jackalaka21/MnT_exoskeleton/Exoskeleton Poster.jpg

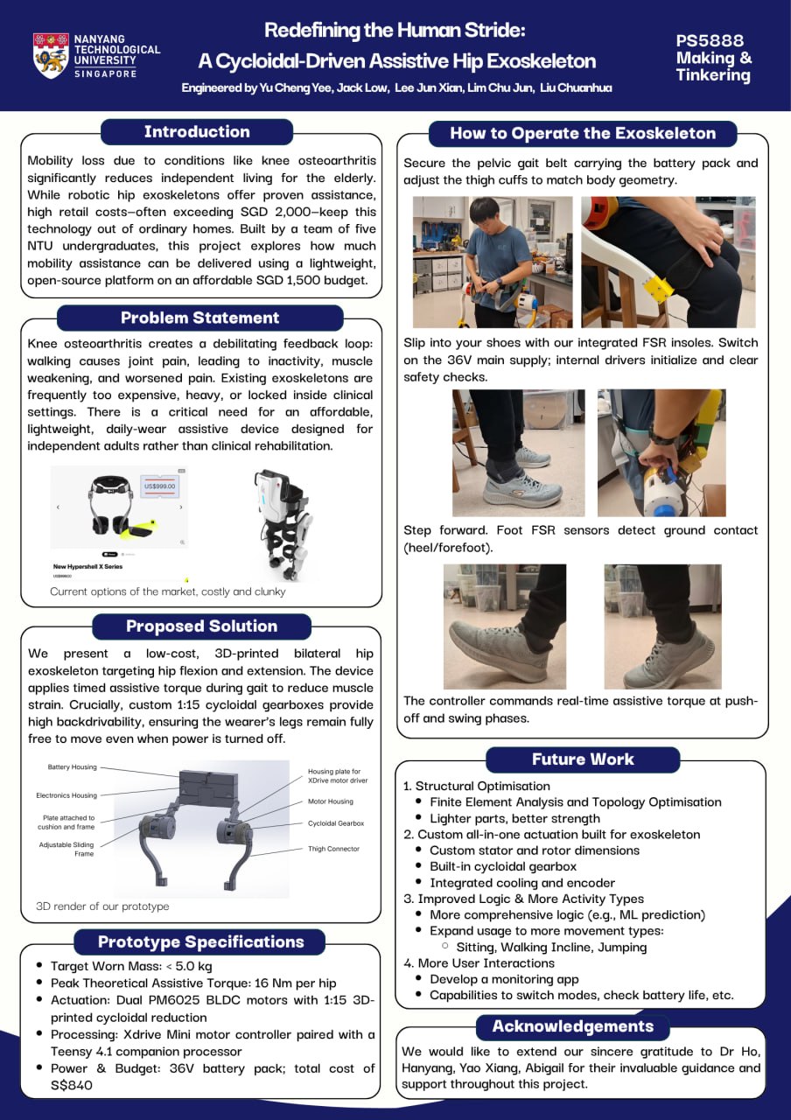
Exoskeleton Poster.jpg
