jackalaka21/MnT_exoskeleton/PS5888_Cycloidal_Driven_Exoskeleton.pdf

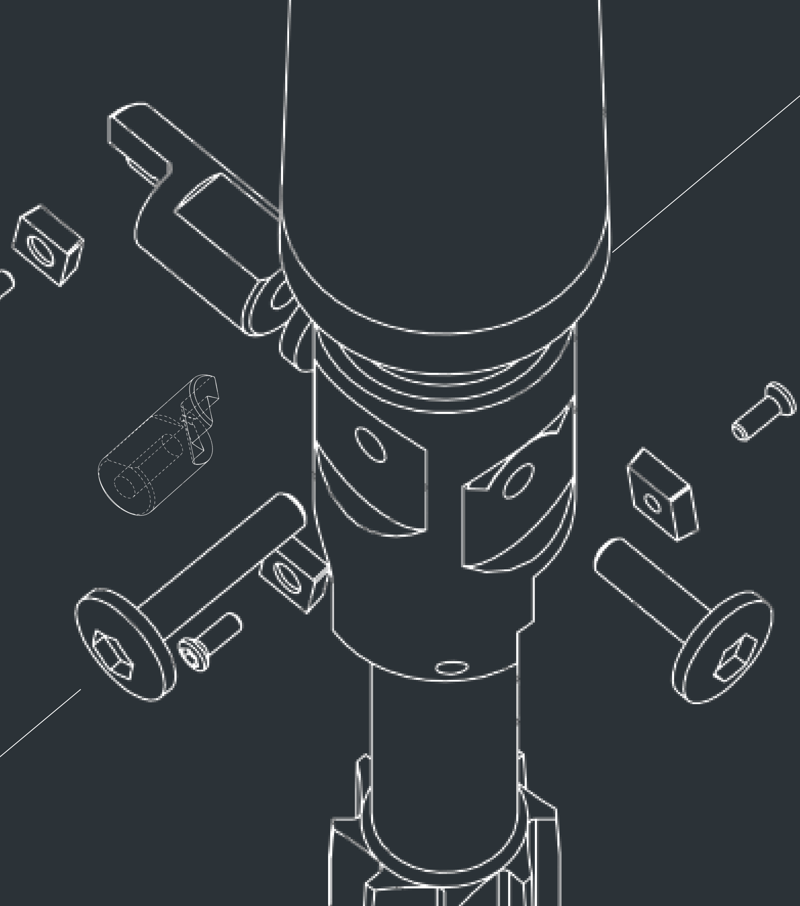
[picture p2: figure]

PRESENTED BY:
YU CHENG YEE, LIU CHUANHUA, LEE JUN XIAN, JACK LOW EE JIN, AND LIM CHU JUN

# Redefining the Human Stride

# Cycloidal-Driven Assistive Hip Exoskeleton

PS5888
Making and Tinkering

1

## The Freedom of Movement

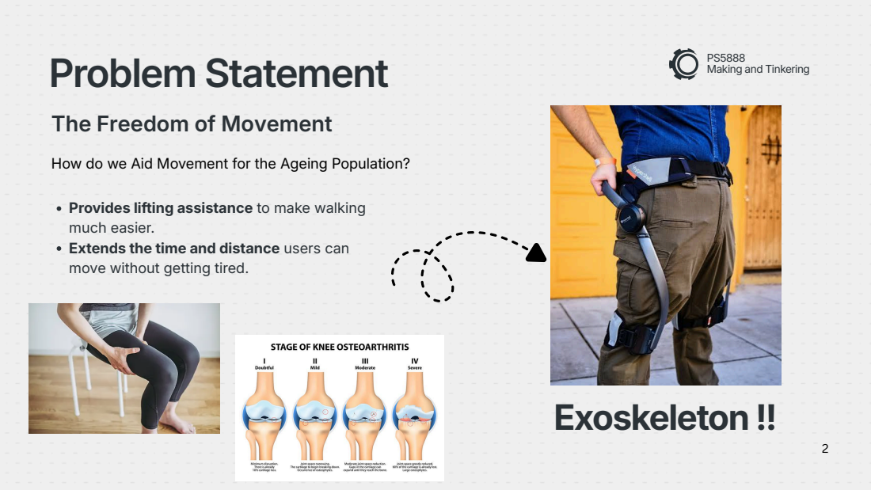
[picture p3: page 2]
Exoskeleton !!

Making and Tinkering Problem Statement

How do we Aid Movement for the Ageing Population?

Provides lifting assistance to make walking
much easier.
Extends the time and distance users can
move without getting tired.

# Problem Statement

However....

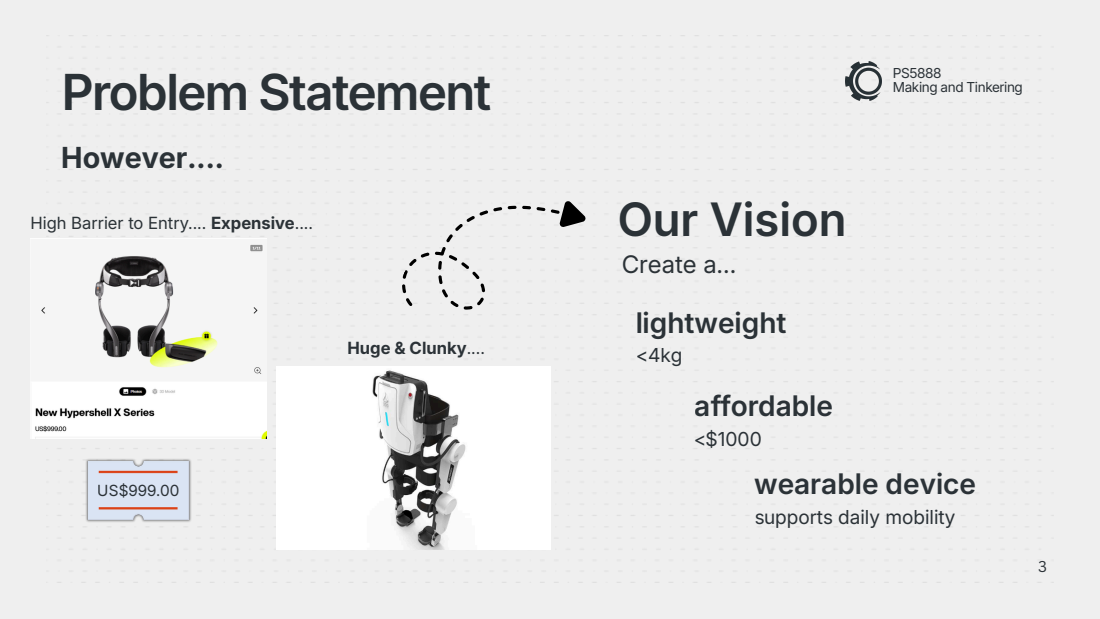
[picture p4: page 3]
lightweight; affordable; wearable device; supports daily mobility; High Barrier to Entry.... Expensive....; Our Vision; Create a...; Huge & Clunky....

Making and Tinkering

# Proposed Initial Design

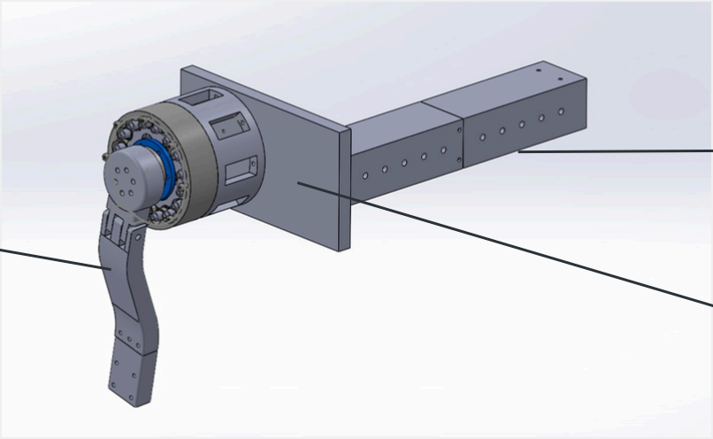
[picture p5: figure]

Flat housing
plate

Hip
Component

Railing + Box for
electronics
(undesigned)

# Initial Circuit Schematics

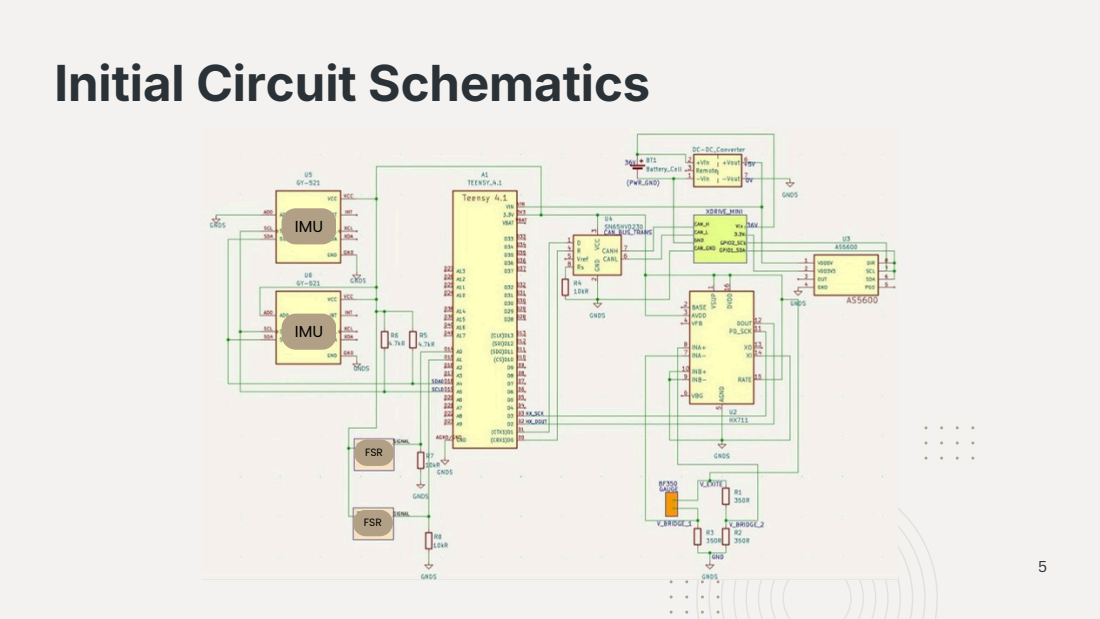
[picture p6: page 5]
IMU; FSR

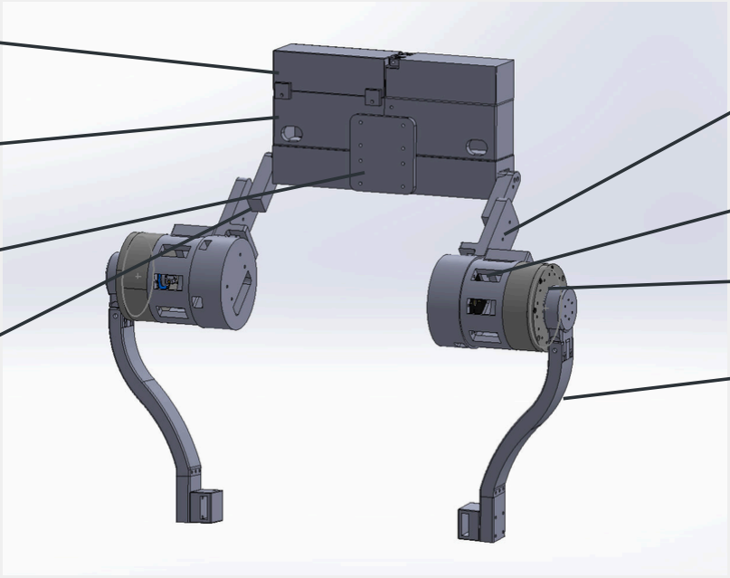
[picture p7: figure]

Battery housing

# Proposed Final Design

Cycloidal gearbox

Motor housing

Housing plate for
Odrive Motor Driver

Electronics housing

Adjustable Sliding
Frame

Plate attached to
cushion and frame

Thigh connector

# Final Circuit Design/Circuitry

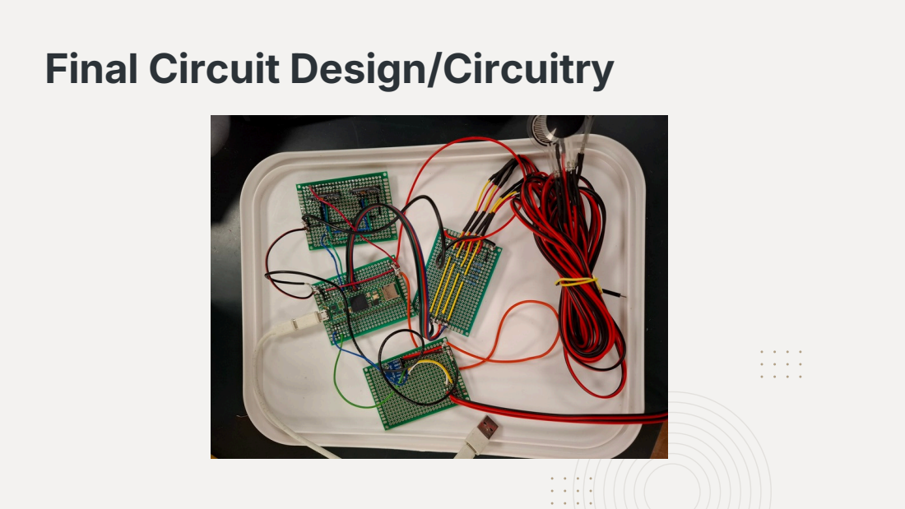
[picture p8: page 7]

# Final Product

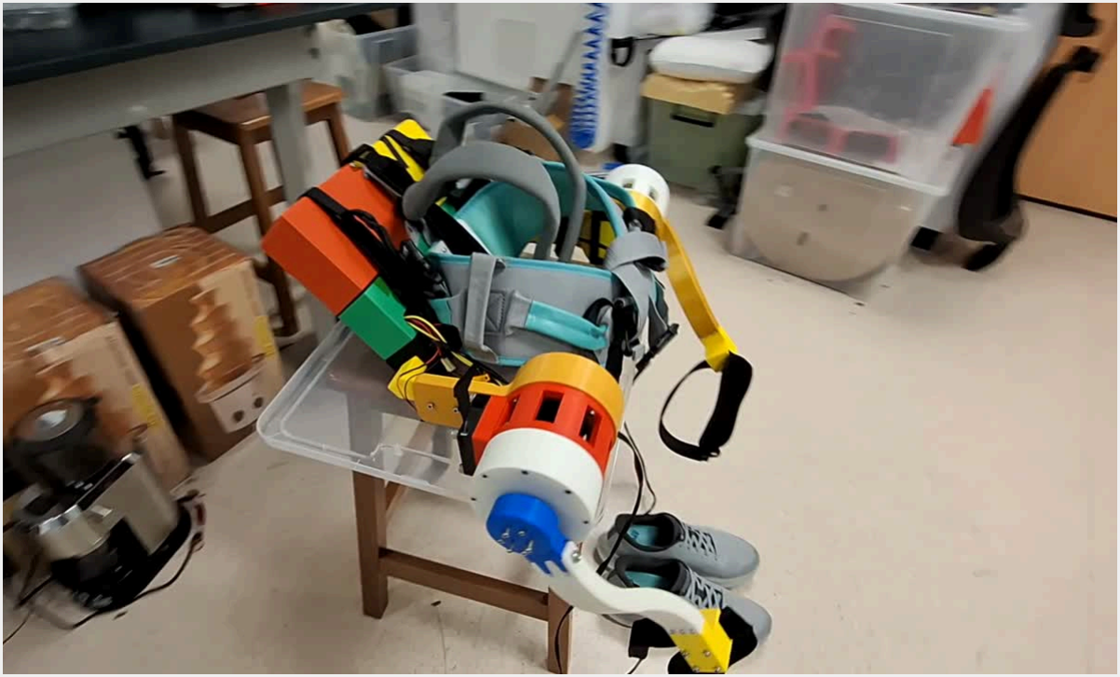
[picture p9: figure]

# Overcame Challenges

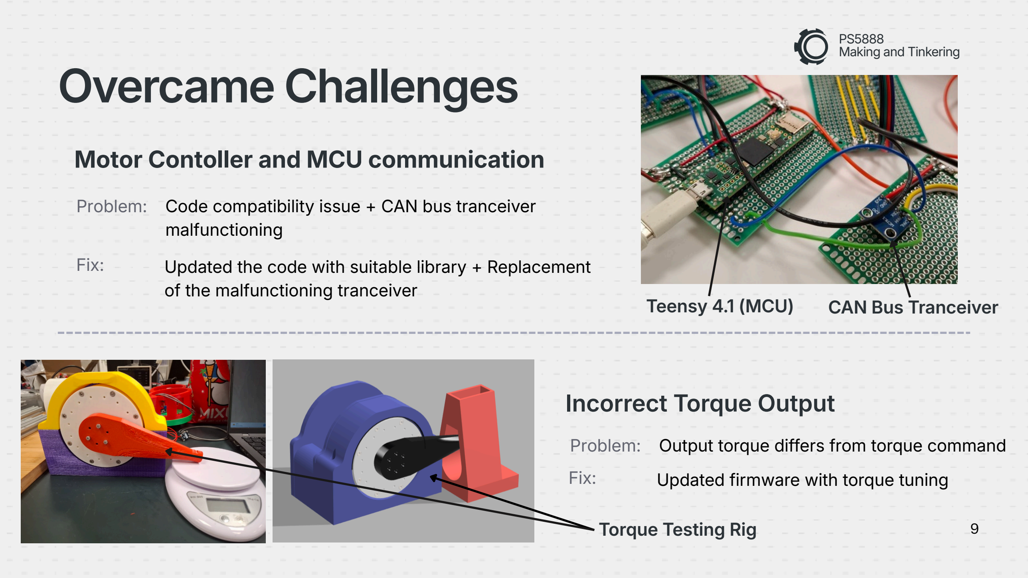
[picture p10: page 9]

PS5888
Making and Tinkering

Torque Testing Rig

Code compatibility issue + CAN bus tranceiver malfunctioning

Updated the code with suitable library + Replacement of the malfunctioning tranceiver

## Motor Contoller and MCU communication

## Incorrect Torque Output

Problem:

Fix:

Output torque differs from torque command Updated firmware with torque tuning

Problem:
Fix:

Teensy 4.1 (MCU) CAN Bus Tranceiver

9

# Overcame Challenges

## Structural Failure Under Stress

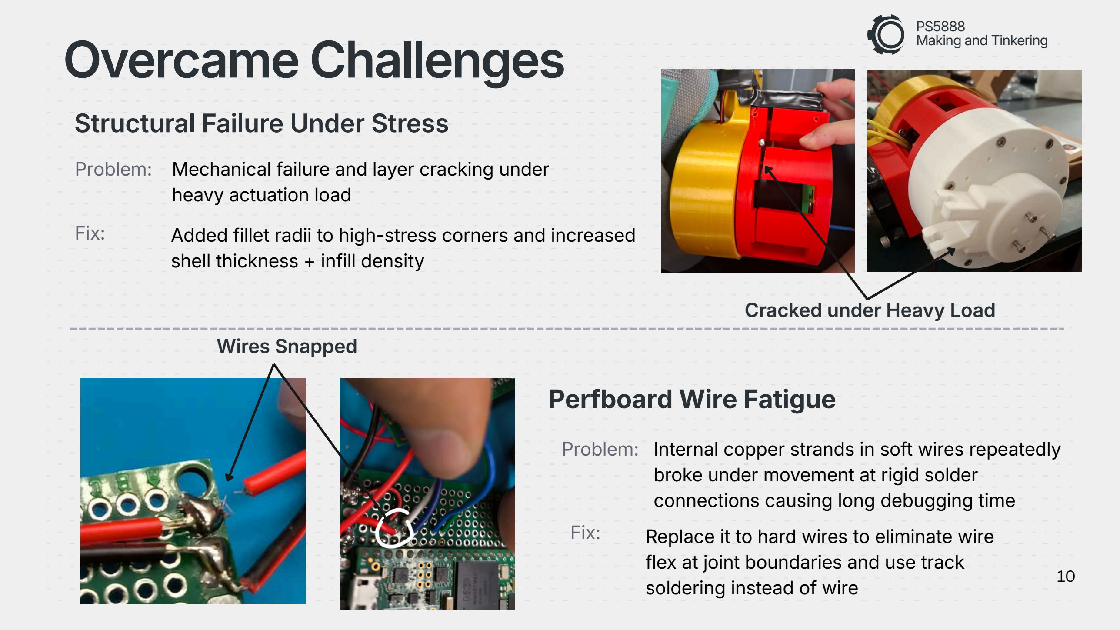
[picture p11: page 10]

PS5888
Making and Tinkering

Cracked under Heavy Load

## Perfboard Wire Fatigue

Internal copper strands in soft wires repeatedly broke under movement at rigid solder connections causing long debugging time Replace it to hard wires to eliminate wire
flex at joint boundaries and use track soldering instead of wire

Problem:

Fix:

Mechanical failure and layer cracking under
heavy actuation load

Added fillet radii to high-stress corners and increased shell thickness + infill density

Problem:

Fix:

Wires Snapped

10

# Challenges to Overcome

## Weight and Size

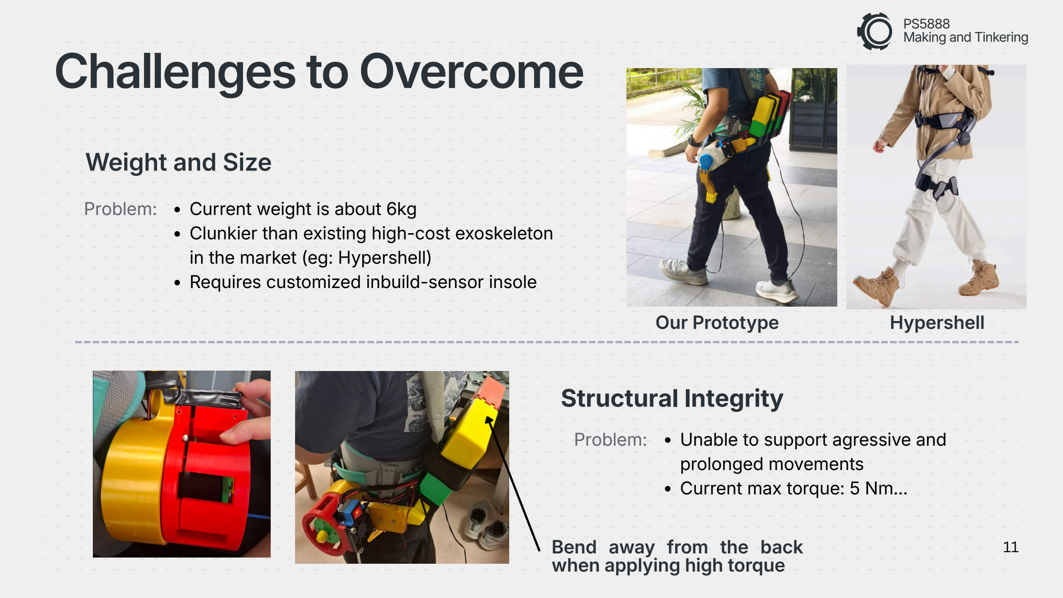
[picture p12: page 11]

PS5888
Making and Tinkering

## Structural Integrity

Unable to support agressive and prolonged movements
Current max torque: 5 Nm...

Problem:

Current weight is about 6kg
Clunkier than existing high-cost exoskeleton in the market (eg: Hypershell)
Requires customized inbuild-sensor insole

Problem:

Our Prototype | Hypershell

Bend away from the back
when applying high torque

11

# Challenges to Overcome

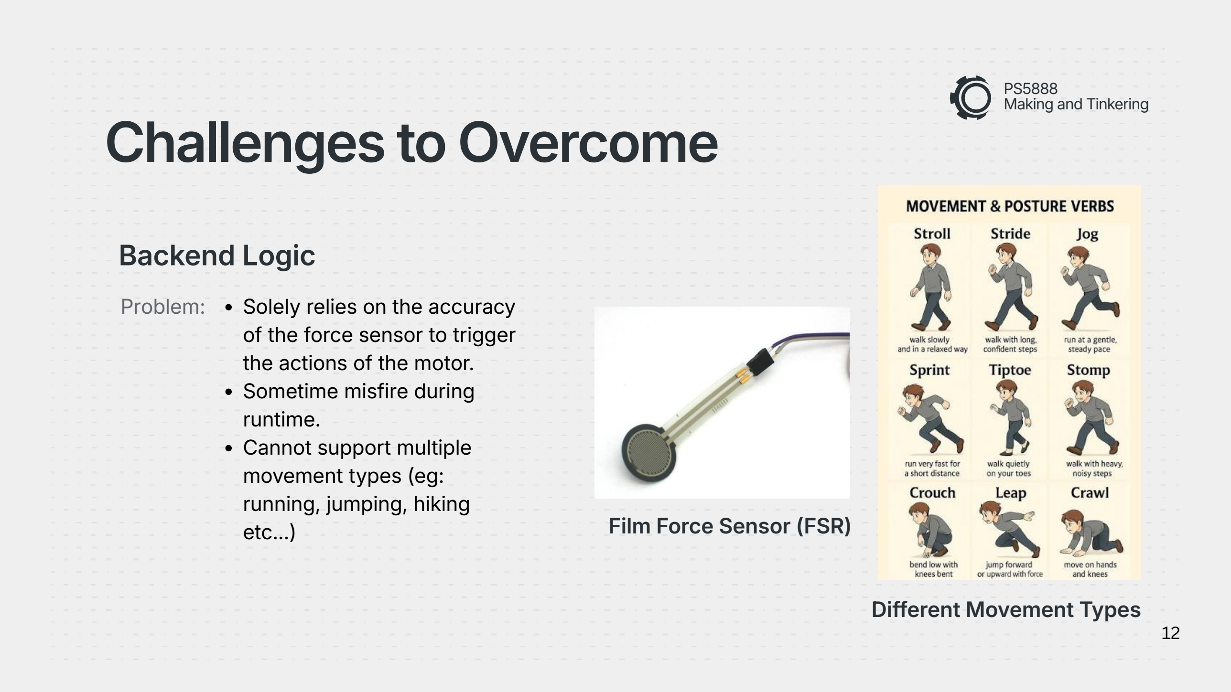
[picture p13: page 12]

PS5888
Making and Tinkering

## Backend Logic

Solely relies on the accuracy of the force sensor to trigger the actions of the motor.
Sometime misfire during
runtime.
Cannot support multiple
movement types (eg:
running, jumping, hiking
etc...)

Problem:

12

Film Force Sensor (FSR)

Different Movement Types

# Role of AI

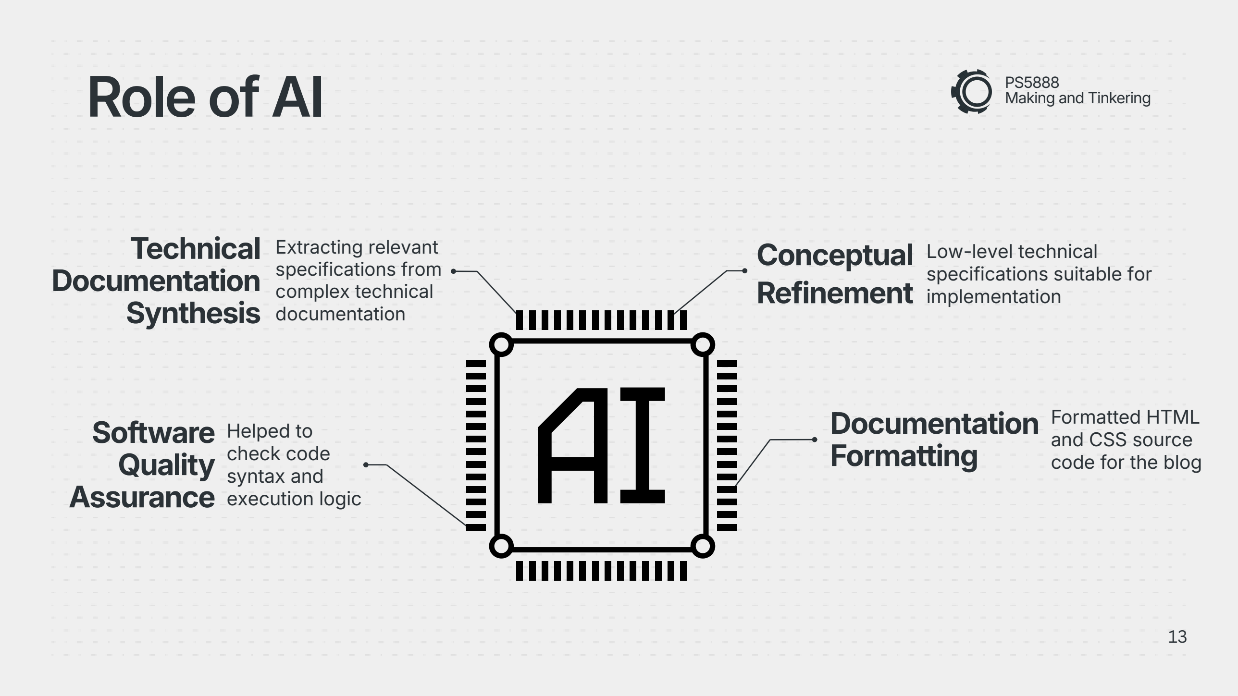
[picture p14: page 13]

## Technical Documentation Synthesis

## Conceptual Refinement

## Documentation Formatting

## Software Quality Assurance

Helped to
check code
syntax and
execution logic

Formatted HTML
and CSS source
code for the blog

Extracting relevant
specifications from
complex technical
documentation

Low-level technical
specifications suitable for implementation

PS5888
Making and Tinkering

13

# Structural Optimisation

# Future Plans

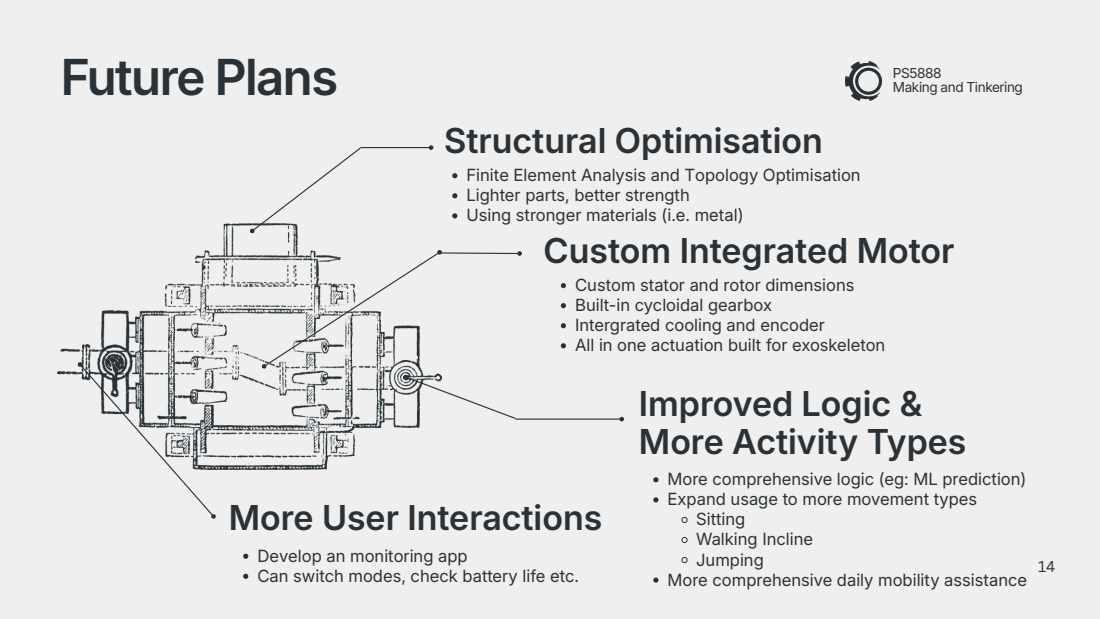
[picture p15: page 14]

Making and Tinkering

Finite Element Analysis and Topology Optimisation
Lighter parts, better strength
Using stronger materials (i.e. metal)
Custom Integrated Motor

Custom stator and rotor dimensions
Built-in cycloidal gearbox
Intergrated cooling and encoder
All in one actuation built for exoskeleton
Improved Logic &
More Activity Types

More comprehensive logic (eg: ML prediction)
Expand usage to more movement types
Sitting
Walking Incline
Jumping
More comprehensive daily mobility assistance

More User Interactions

Develop an monitoring app
Can switch modes, check battery life etc.

# Final Expenditure

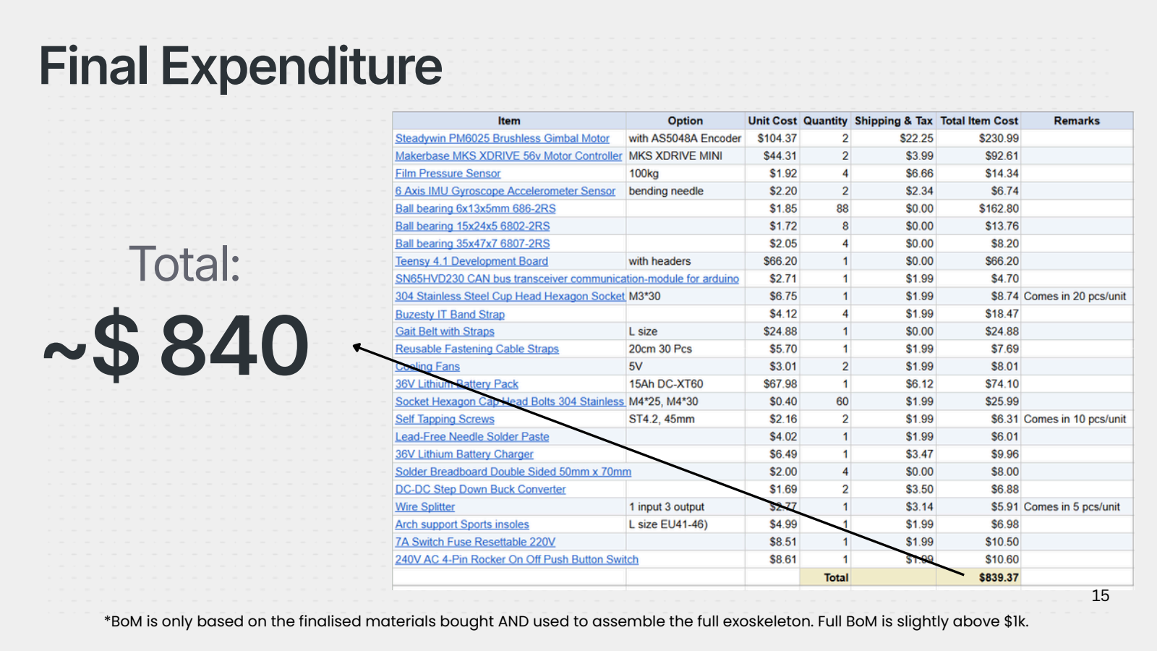
[picture p16: page 15]

*BoM is only based on the finalised materials bought AND used to assemble the full exoskeleton. Full BoM is slightly above $1k.

~$ 840

# Total:

15

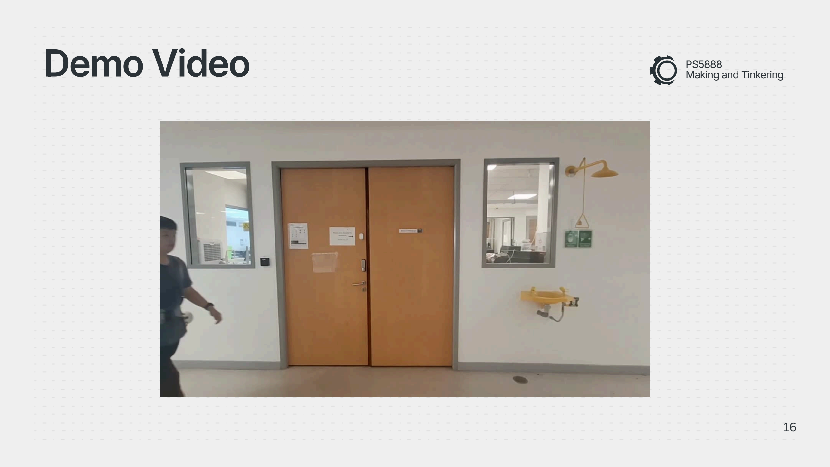
[picture p17: page 16]

PS5888 Demo Video | Making and Tinkering

16

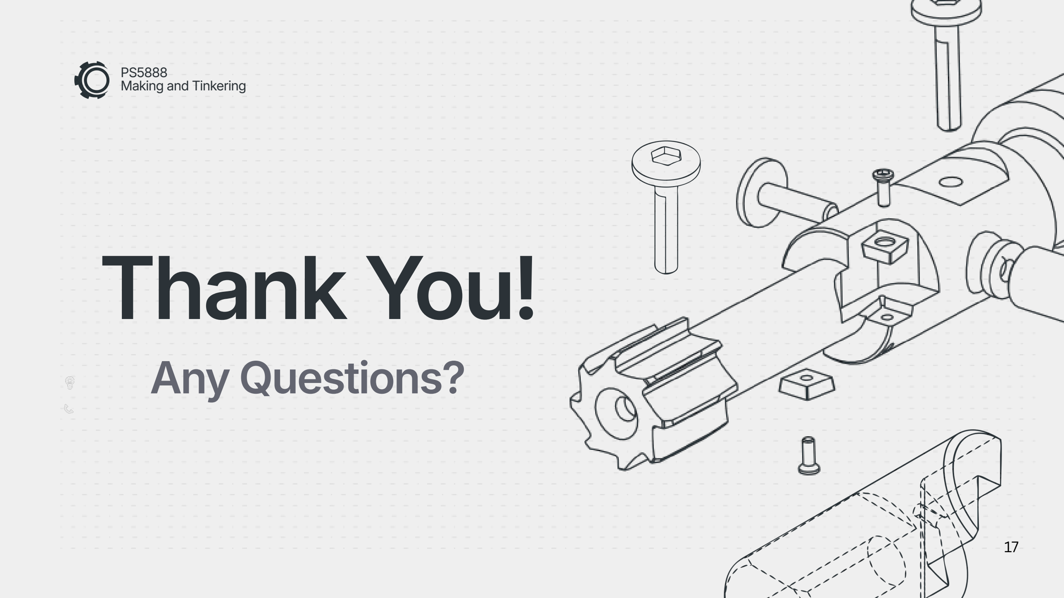
[picture p18: page 17]

# Thank You!

PS5888
Making and Tinkering

# Any Questions?

17
