jackalaka21/MnT_exoskeleton/Assem1.SLDASM

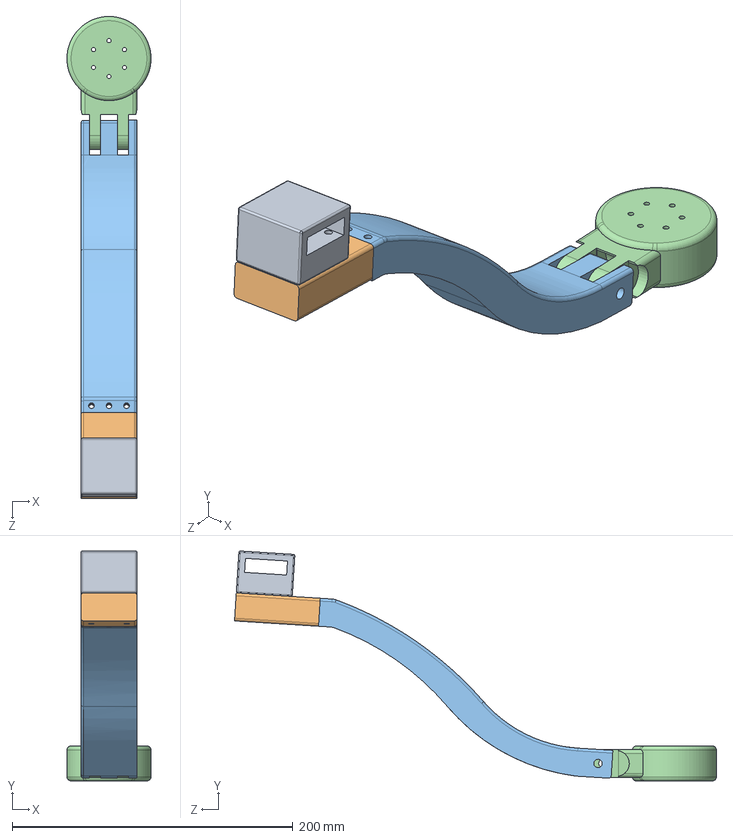
[picture p19: CAD file, 2026-07-16]
Assem1.SLDASM
60.0 x 163.9 x 343.6 mm
HC1
HC2
HC3
HC4 (Thigh Connector)
