jackalaka21/MnT_exoskeleton/Hip Component/Assem2.SLDASM

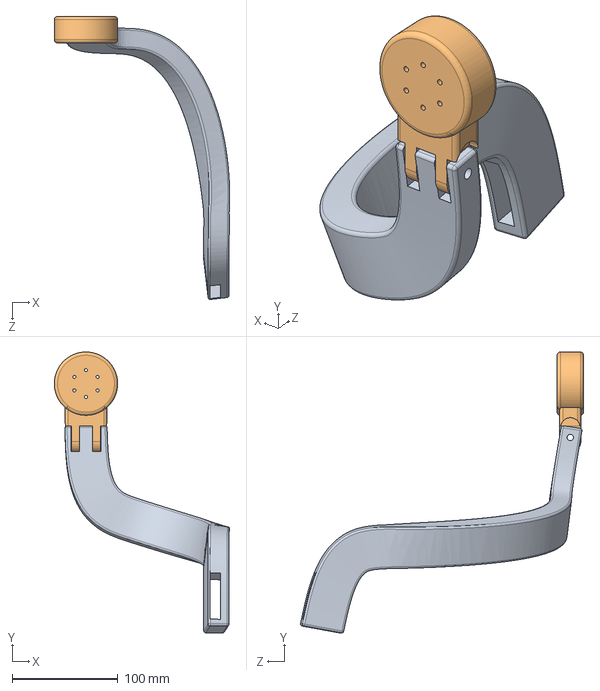
[picture p20: CAD file, 2026-08-24]
Hip Component/Assem2.SLDASM
166.1 x 266.2 x 268.1 mm
HC1
HC5
