jackalaka21/MnT_exoskeleton/E Box (Full).SLDPRT

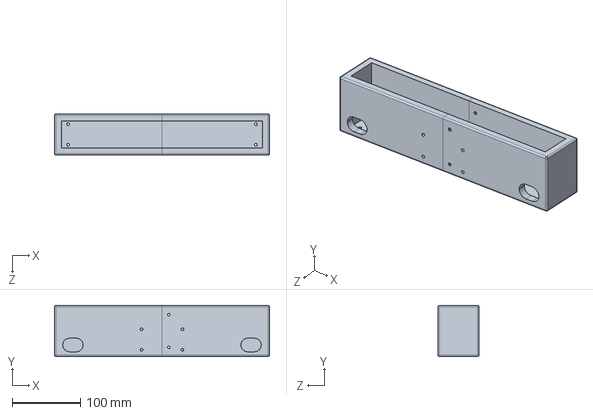
[picture p21: CAD file, 2026-07-16]
E Box (Full).SLDPRT
315.0 x 75.0 x 60.0 mm
