jackalaka21/MnT_exoskeleton/Cycloidal_Gearbox/Motor - Cycloidal Subassembly.SLDASM

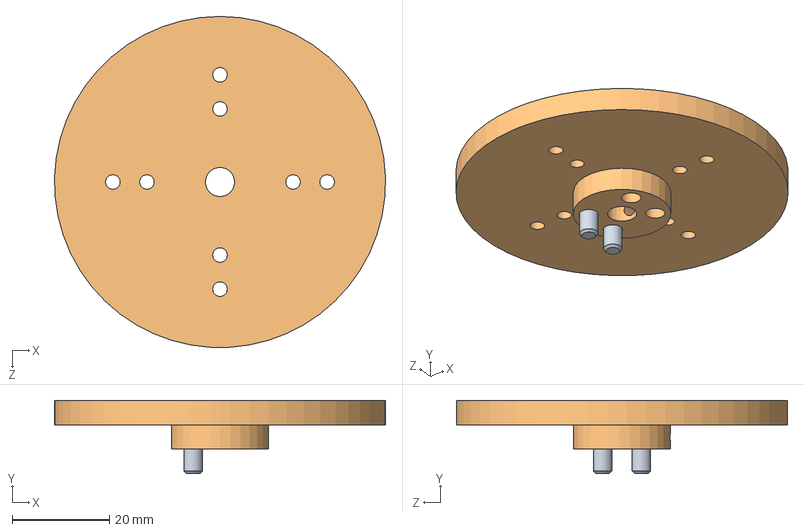
[picture p22: CAD file, 2026-08-24]
Cycloidal_Gearbox/Motor - Cycloidal Subassembly.SLDASM
68.0 x 15.0 x 68.0 mm
PM6025 - Cycloidal Adapter
Shaft for Motor-Gearbox Adapter x 2
