jackalaka21/MnT_exoskeleton/HC2.SLDPRT

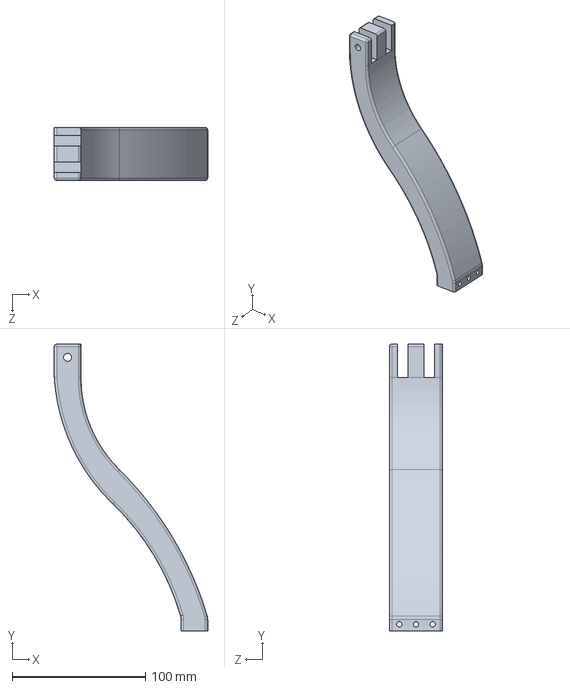
[picture p23: CAD file, 2026-07-16]
HC2.SLDPRT
115.0 x 215.0 x 40.0 mm
