jackalaka21/MnT_exoskeleton/Hip Component/HC1.SLDPRT

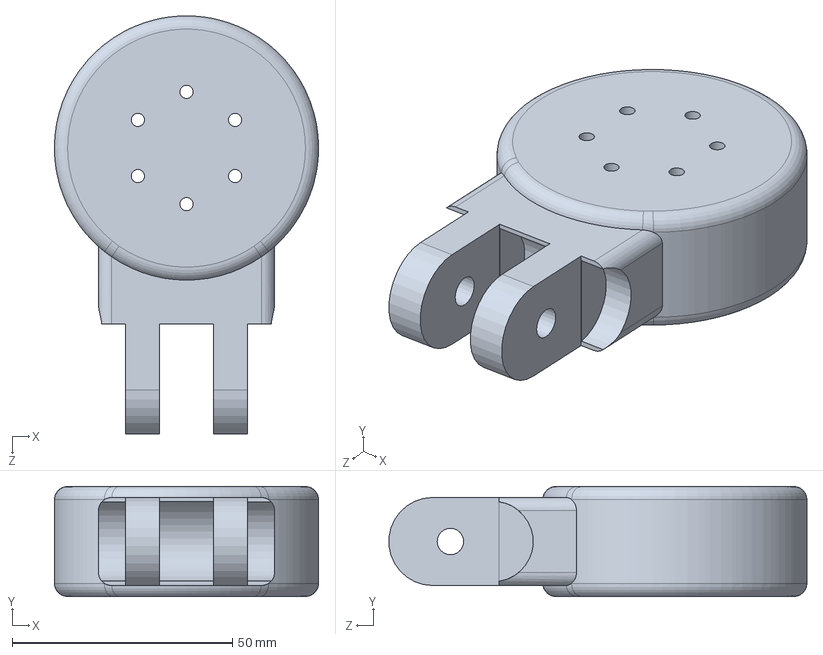
[picture p24: CAD file, 2026-08-24]
Hip Component/HC1.SLDPRT
60.0 x 25.0 x 94.9 mm
