jackalaka21/MnT_exoskeleton/Cycloidal_Gearbox/Shaft for Motor-Gearbox Adapter.SLDPRT

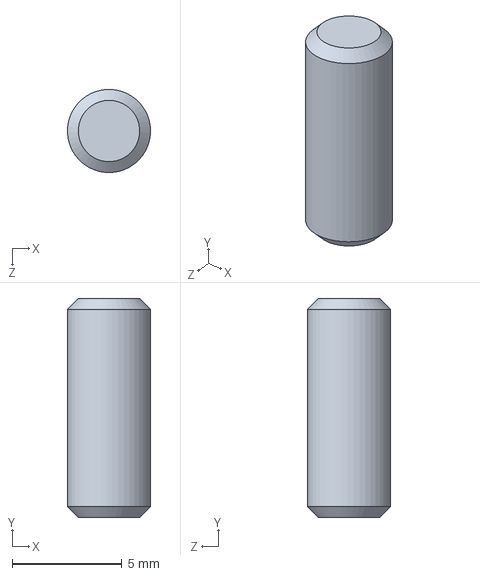
[picture p25: CAD file, 2026-08-24]
Cycloidal_Gearbox/Shaft for Motor-Gearbox Adapter.SLDPRT
3.80 x 10.0 x 3.80 mm
