jackalaka21/MnT_exoskeleton/Hip Component/HC5.SLDPRT

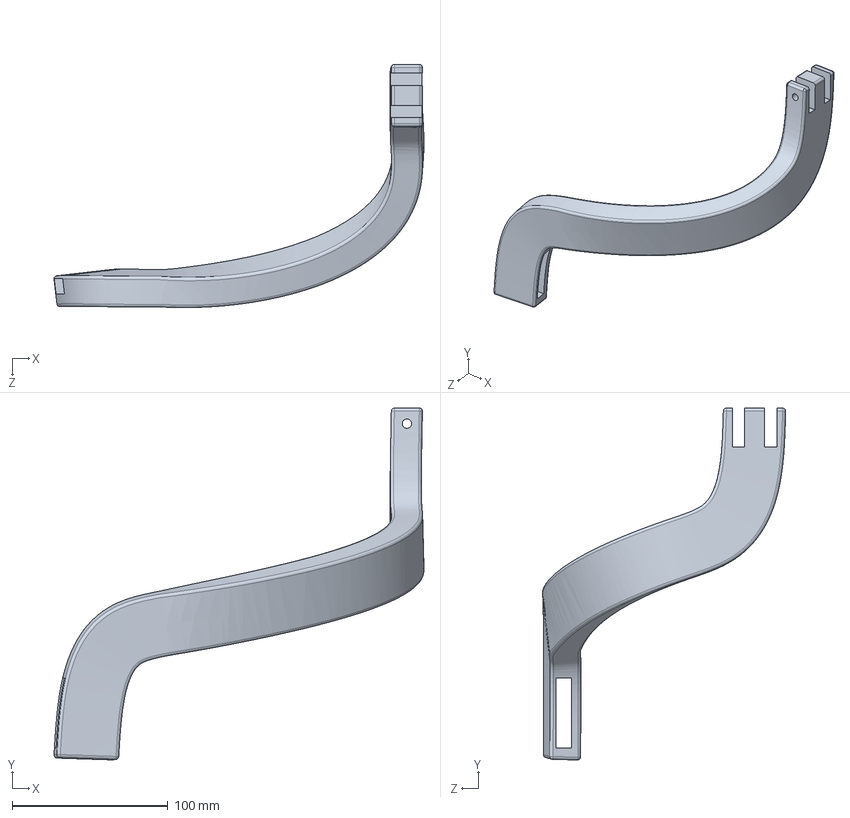
[picture p26: CAD file, 2026-08-24]
Hip Component/HC5.SLDPRT
237.4 x 225.7 x 156.1 mm
