jackalaka21/MnT_exoskeleton/HC1.SLDPRT

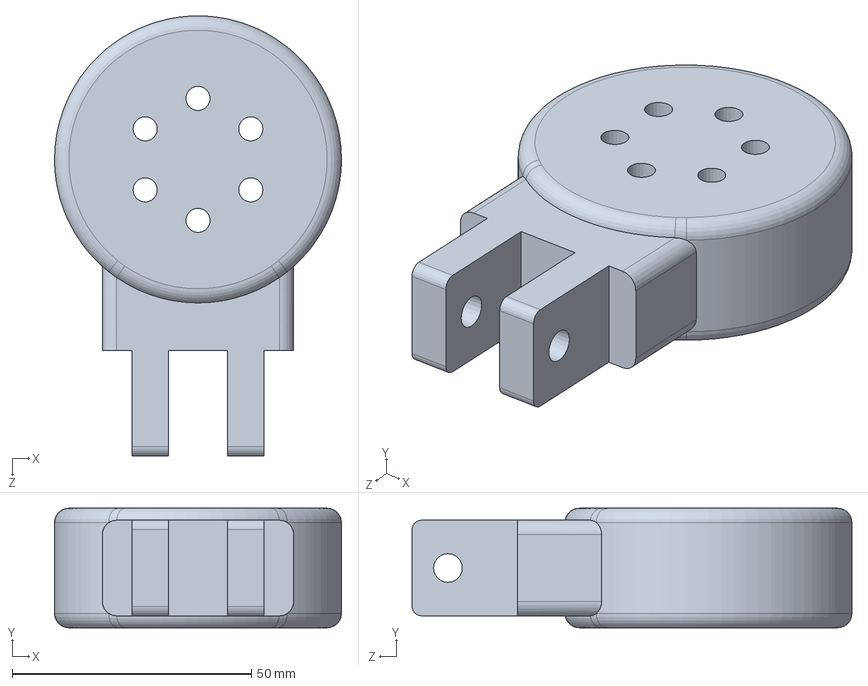
[picture p27: CAD file, 2026-07-16]
HC1.SLDPRT
60.0 x 25.0 x 92.0 mm
