jackalaka21/MnT_exoskeleton/Back Railing.SLDPRT

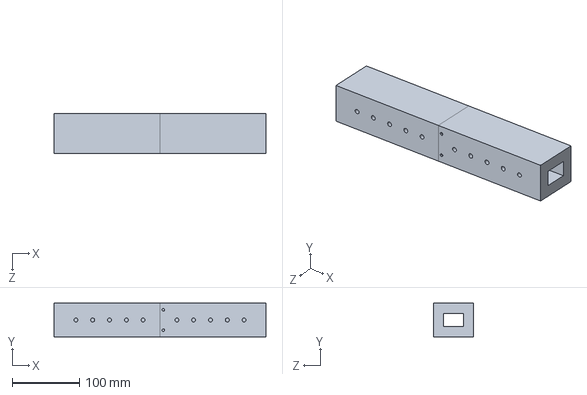
[picture p28: CAD file, 2026-07-16]
Back Railing.SLDPRT
315.0 x 50.0 x 60.0 mm
