jackalaka21/MnT_exoskeleton/BR2.SLDPRT

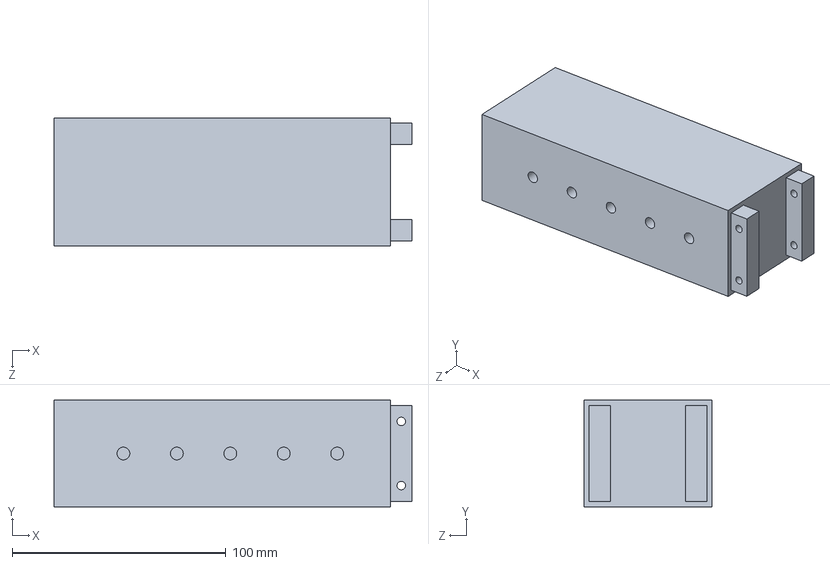
[picture p29: CAD file, 2026-07-16]
BR2.SLDPRT
167.5 x 50.0 x 60.0 mm
