jackalaka21/MnT_exoskeleton/Cut-Extrude8[2].SLDPRT

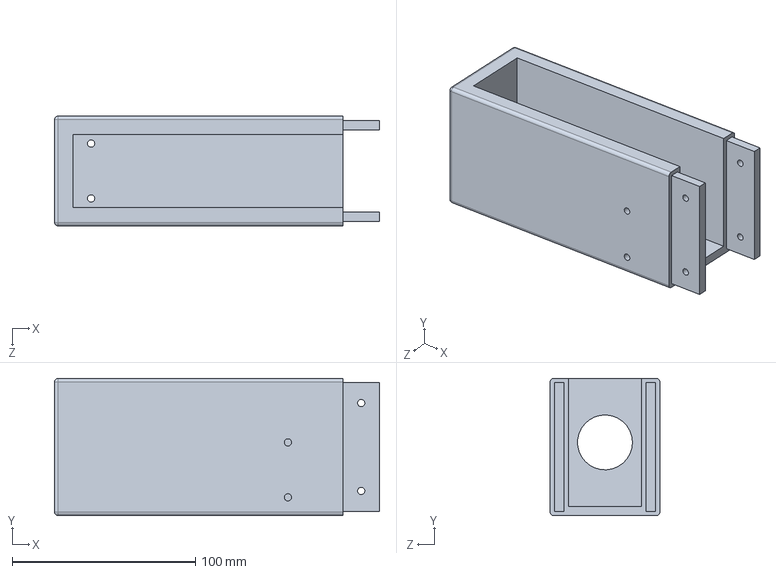
[picture p30: CAD file, 2026-07-16]
Cut-Extrude8[2].SLDPRT
177.5 x 75.0 x 60.0 mm
