jackalaka21/MnT_exoskeleton/Hip Component/HC3.SLDPRT

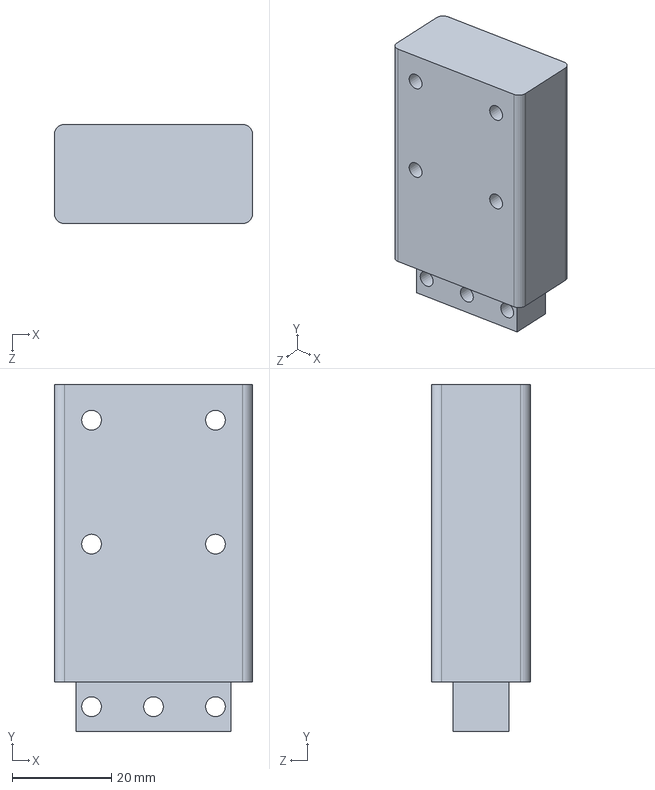
[picture p31: CAD file, 2026-07-16]
Hip Component/HC3.SLDPRT
40.0 x 70.0 x 20.0 mm
