jackalaka21/MnT_exoskeleton/E Box 2.SLDPRT

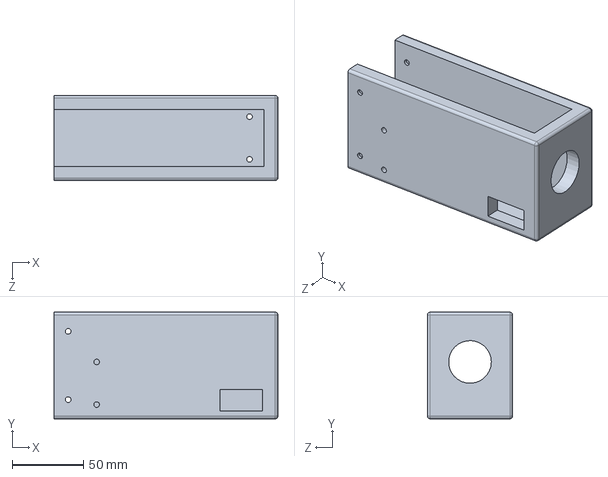
[picture p32: CAD file, 2026-07-16]
E Box 2.SLDPRT
157.5 x 75.0 x 60.0 mm
