jackalaka21/MnT_exoskeleton/Hip Component/HC4 (Thigh Connector).SLDPRT

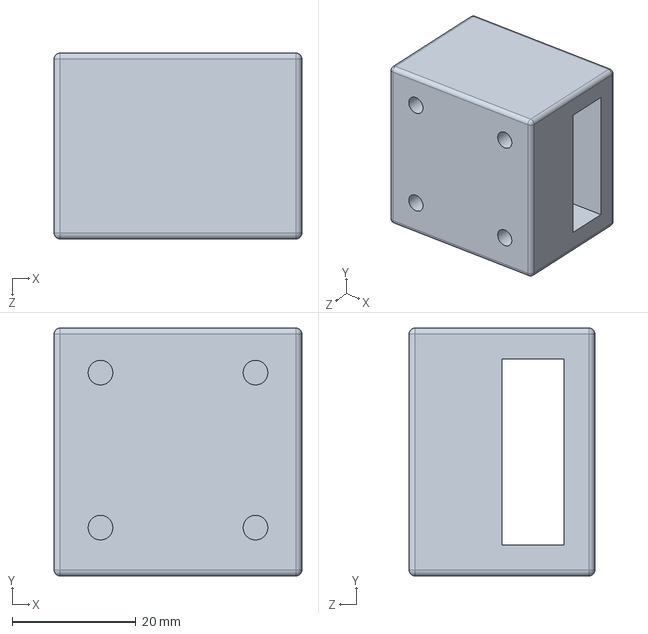
[picture p33: CAD file, 2026-07-16]
Hip Component/HC4 (Thigh Connector).SLDPRT
40.0 x 40.0 x 30.0 mm
