jackalaka21/MnT_exoskeleton/Cycloidal_Gearbox/PM6025 - Cycloidal Adapter.SLDPRT

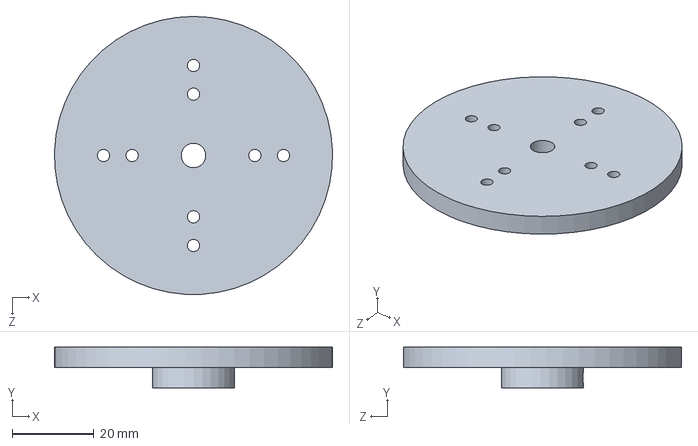
[picture p34: CAD file, 2026-08-24]
Cycloidal_Gearbox/PM6025 - Cycloidal Adapter.SLDPRT
68.0 x 10.0 x 68.0 mm
