jackalaka21/MnT_exoskeleton/BR1.SLDPRT

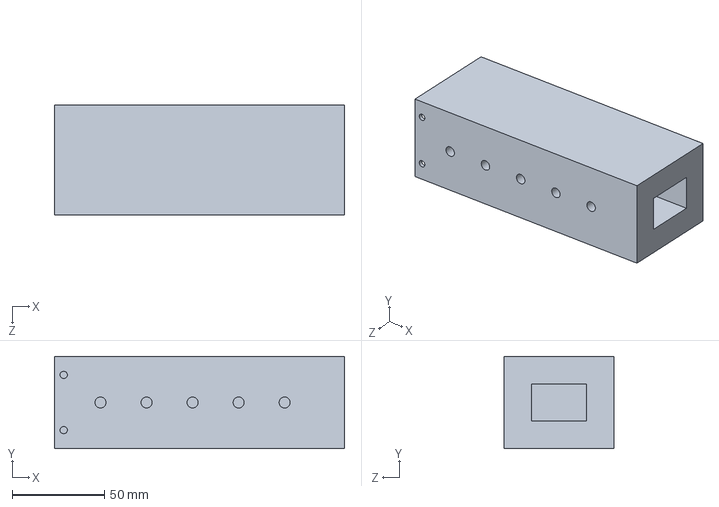
[picture p35: CAD file, 2026-07-16]
BR1.SLDPRT
157.5 x 50.0 x 60.0 mm
