jackalaka21/MnT_exoskeleton/Handle.SLDPRT

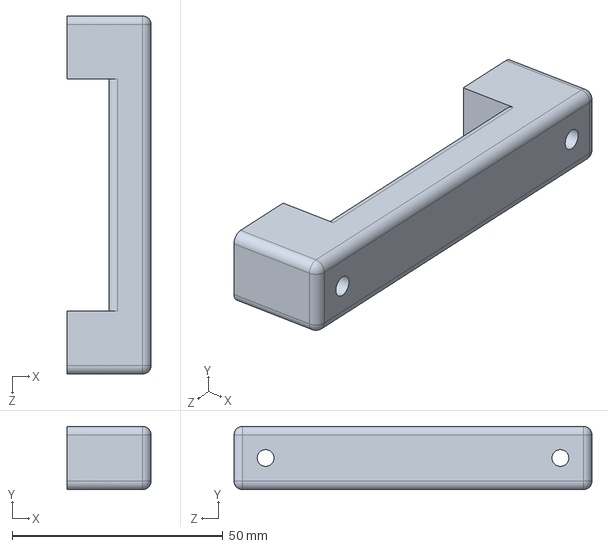
[picture p36: CAD file, 2026-07-16]
Handle.SLDPRT
20.0 x 15.0 x 85.0 mm
