jackalaka21/MnT_exoskeleton/Frame Slider.SLDPRT

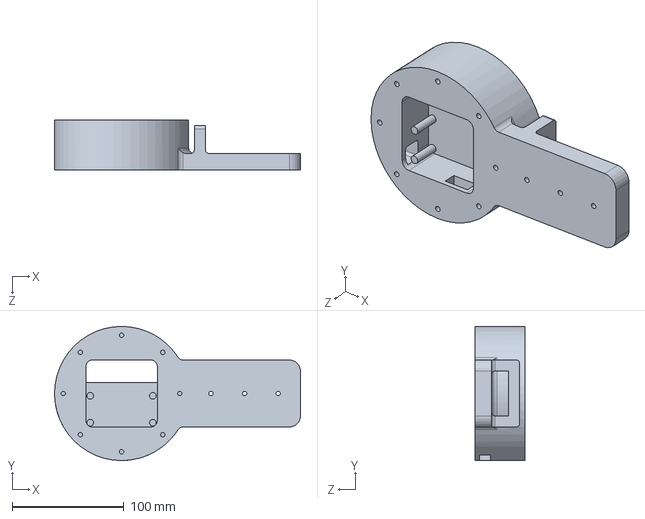
[picture p37: CAD file, 2026-07-16]
Frame Slider.SLDPRT
220.0 x 120.0 x 45.0 mm
