jackalaka21/MnT_exoskeleton/Frame.STL

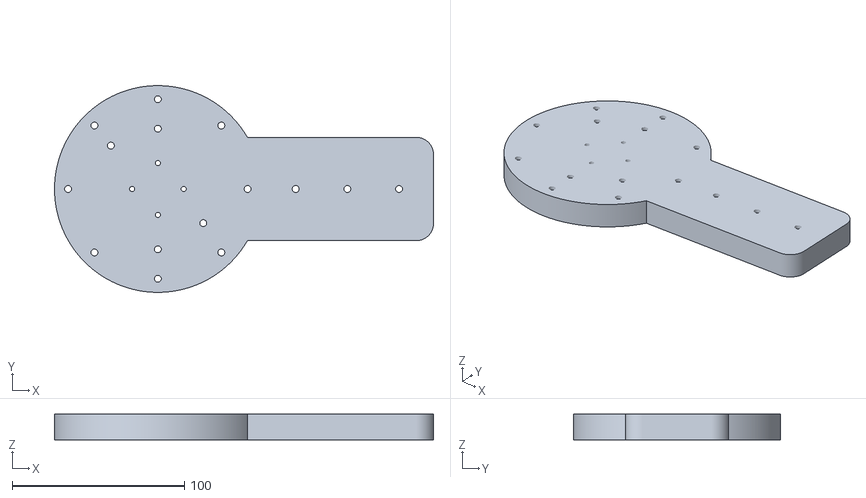
[picture p38: CAD file, 2026-07-16]
Frame.STL
220.0 x 120.0 x 15.0
