jackalaka21/MnT_exoskeleton/Cycloidal_Gearbox/Distance ring 4mm ID 6mm.STEP.SLDPRT

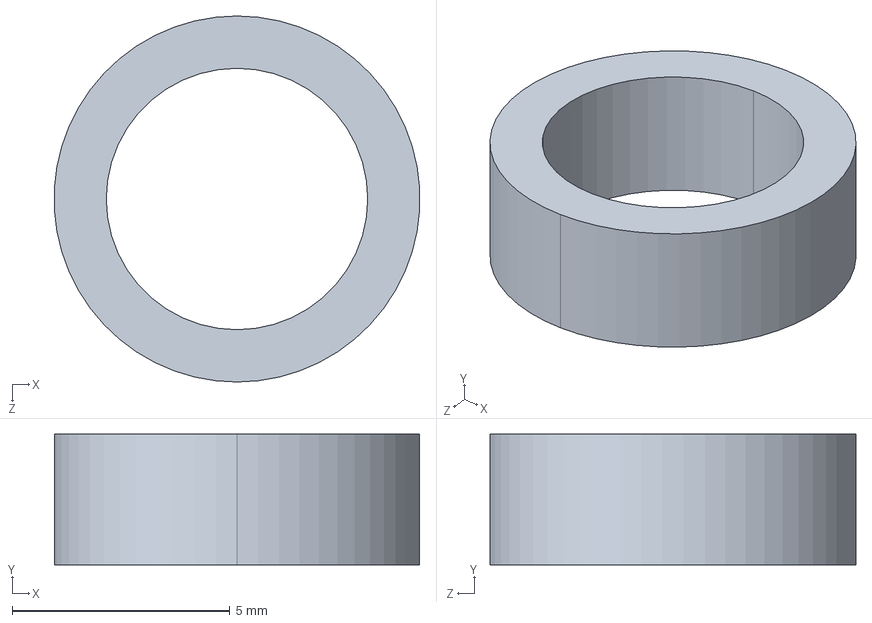
[picture p39: CAD file, 2026-08-24]
Cycloidal_Gearbox/Distance ring 4mm ID 6mm.STEP.SLDPRT
8.39 x 3.00 x 8.40 mm
