jackalaka21/MnT_exoskeleton/Cycloidal_Gearbox/6mm shaft for output roller pins.STEP.SLDPRT

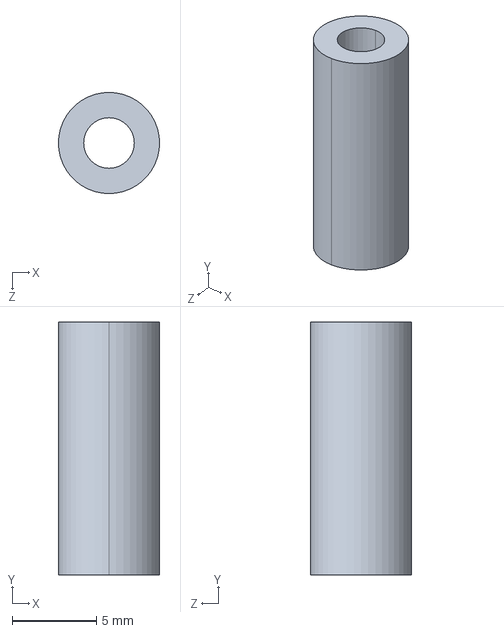
[picture p40: CAD file, 2026-08-24]
Cycloidal_Gearbox/6mm shaft for output roller pins.STEP.SLDPRT
6.00 x 15.0 x 6.00 mm
