jackalaka21/MnT_exoskeleton/Cycloidal_Gearbox/5.9mm shaft for roller pins.SLDPRT

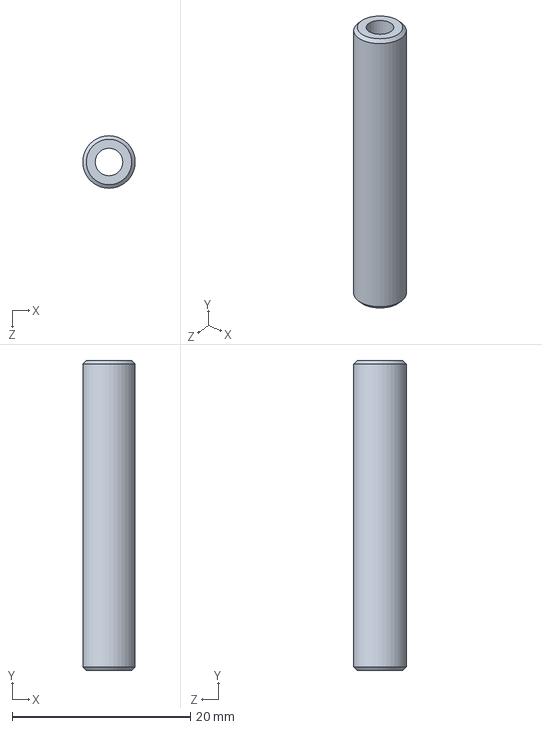
[picture p41: CAD file, 2026-08-24]
Cycloidal_Gearbox/5.9mm shaft for roller pins.SLDPRT
5.88 x 34.8 x 5.90 mm
