jackalaka21/MnT_exoskeleton/Cycloidal_Gearbox/6mm shaft for roller pins.STEP.SLDPRT

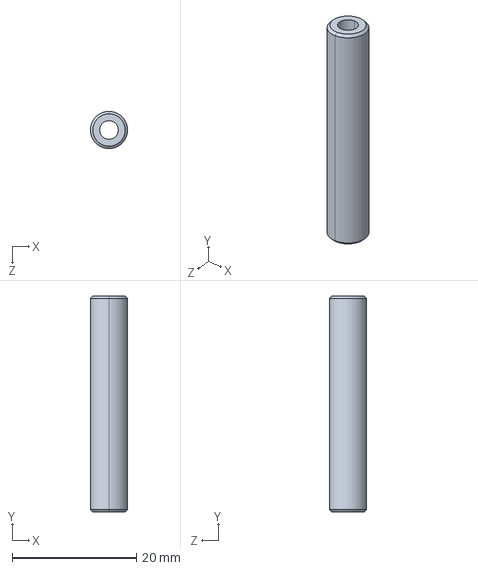
[picture p42: CAD file, 2026-08-24]
Cycloidal_Gearbox/6mm shaft for roller pins.STEP.SLDPRT
5.98 x 34.8 x 6.00 mm
