jackalaka21/MnT_exoskeleton/Cycloidal_Gearbox/Stepper NEMA 17 -  20mm shaft r1_Stepper NEMA 17 -  20mm shaft.STEP.SLDPRT

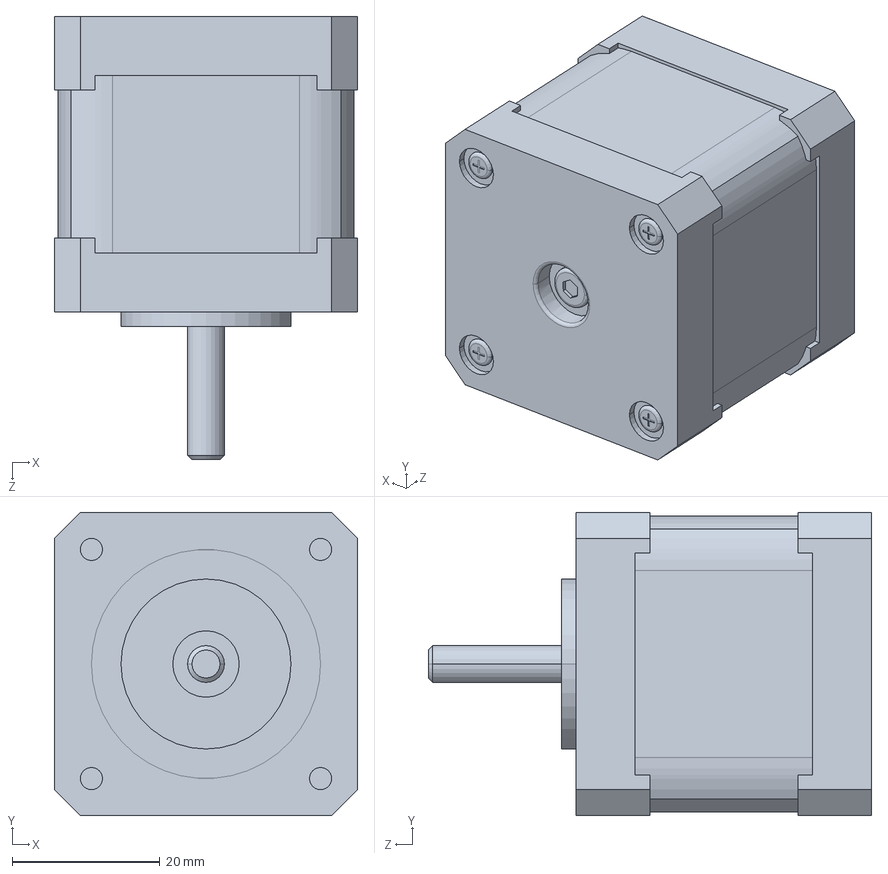
[picture p43: CAD file, 2026-08-24]
Cycloidal_Gearbox/Stepper NEMA 17 - 20mm shaft r1_Stepper NEMA 17 - 20mm shaft.STEP.SLDPRT
41.0 x 41.0 x 60.0 mm
