jackalaka21/MnT_exoskeleton/Cycloidal_Gearbox/Cycloidal Drive - 3D Printable DIY.SLDASM

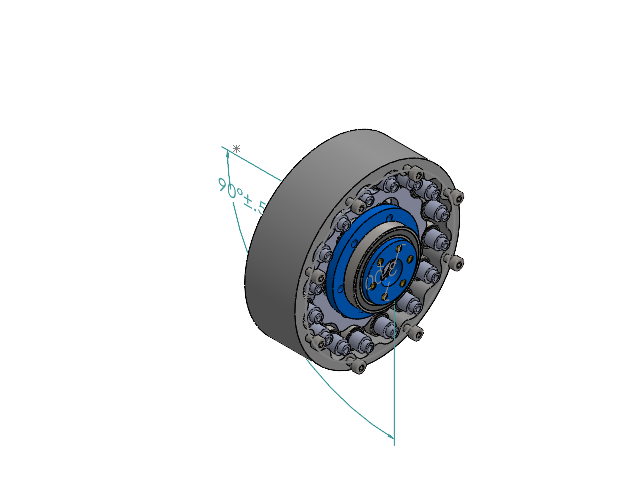
[picture p44: CAD file, 2026-08-24]
Cycloidal_Gearbox/Cycloidal Drive - 3D Printable DIY.SLDASM
Input shaft - p1.STEP
Input shaft - p2.STEP
Input shaft - p3.STEP
Input shaft - p4.STEP
Distance ring 1mm ID 15mm.STEP x 6
Ball Bearing-15x24x5mm_Ball Bearing 608 - 8x22x7mm.STEP x 4
Roller pins housing.STEP
6mm shaft for roller pins.STEP x 16
Spacer 6mm ID.STEP x 16
Ball Bearing- 6x13x5mm_Ball Bearing 608 - 8x22x7mm.STEP x 44
Spacer 6mm ID v3.STEP x 16
Spacer 6mm ID v2.STEP x 16
Cycloidal disk.STEP
Cycloidal disk 2.STEP
Output disk flange p1.STEP
Ball Bearing-35x47x7mm_Ball Bearing 608 - 8x22x7mm.STEP x 2
Output disk flange p2.STEP
6mm shaft for output roller pins.STEP x 6
Distance ring 1mm ID 6mm.STEP x 12
Distance ring 4mm ID 6mm.STEP x 6
DIN 912 M3 x 20 --- 20N_DIN 912 M3 x 20 --- 20N.STEP x 6
Threaded insert M4 - L5mm.STEP x 8
EN ISO 4762 M4 x 40 - 20N_EN ISO 4762 M4 x 40 - 20N.STEP x 8
EN ISO 4762 M3 x 30 - 18N_EN ISO 4762 M3 x 30 - 18N.STEP x 2
EN ISO 4762 M3 x 10 - 10N_EN ISO 4762 M3 x 10 - 10N.STEP x 4
Threaded insert M3 - L5mm.STEP x 8
