jackalaka21/MnT_exoskeleton/mks xdrive mini assm.SLDASM

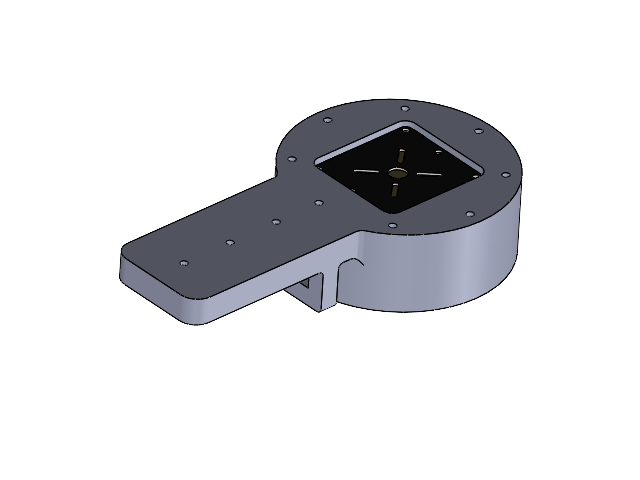
[picture p45: CAD file, 2026-07-16]
mks xdrive mini assm.SLDASM
2026-01-28-18-03-35-684.step x 5
2026-01-28-18-03-35-685.step x 5
2026-01-28-18-03-35-687.step x 2
2026-01-28-18-03-35-688.step x 2
2026-01-28-18-03-35-689.step x 2
2026-01-28-18-03-35-690.step x 8
2026-01-28-18-03-35-692.step
2026-01-28-18-03-35-693.step
2026-01-28-18-03-35-694.step x 2
2026-01-28-18-03-35-695.step x 2
2026-01-28-18-03-35-696.step x 4
2026-01-28-18-03-35-697.step x 16
2026-01-28-18-03-35-698.step x 4
2026-01-28-18-03-35-701.step
2026-01-28-18-03-35-677.step
2026-01-28-18-03-35-679.step
2026-01-28-18-03-19-296.step
2026-01-28-18-03-19-297.step
2026-01-28-18-03-19-298.step
2026-01-28-18-03-19-299.step
2026-01-28-18-03-19-300.step
2026-01-28-18-03-19-301.step
2026-01-28-18-03-19-302.step
2026-01-28-18-03-38-226.step
2026-01-28-18-03-38-227.step
2026-01-28-18-03-38-228.step
2026-01-28-18-03-38-229.step
2026-01-28-18-03-38-230.step
2026-01-28-18-03-38-231.step
2026-01-28-18-03-38-232.step
2026-01-28-18-03-38-233.step
2026-01-28-18-03-38-234.step
2026-01-28-18-03-38-235.step
2026-01-28-18-03-27-436.step
2026-01-28-18-03-27-437.step
2026-01-28-18-03-27-438.step
2026-01-28-18-03-27-439.step
2026-01-28-18-03-27-440.step
2026-01-28-18-03-27-441.step
2026-01-28-18-03-27-442.step
2026-01-28-18-03-42-256.step x 2
2026-01-28-18-03-15-810.step x 2
2026-01-28-18-03-13-456.step
2026-01-28-18-04-02-818.step
Frame Slider
