jackalaka21/MnT_exoskeleton/Full Exo Assm.SLDASM

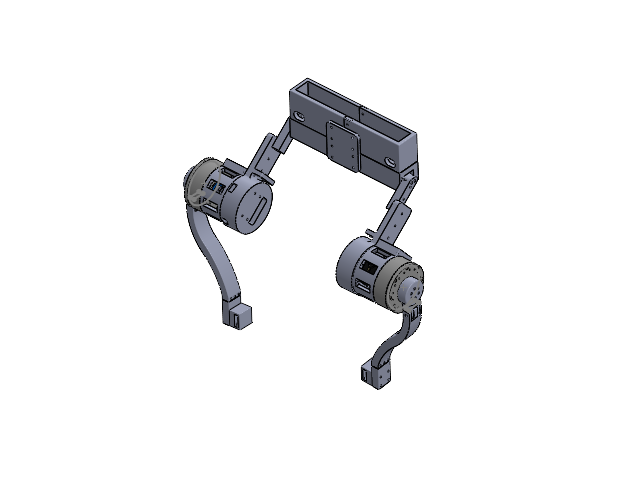
[picture p46: CAD file, 2026-07-16]
Full Exo Assm.SLDASM
Back Railing
E Box (Full)
Sandwiching Plate
Slider
Slider (Mirrored)
2026-01-28-18-03-35-684.step x 10
2026-01-28-18-03-35-685.step x 10
2026-01-28-18-03-35-687.step x 4
2026-01-28-18-03-35-688.step x 4
2026-01-28-18-03-35-689.step x 4
2026-01-28-18-03-35-690.step x 16
2026-01-28-18-03-35-692.step x 2
2026-01-28-18-03-35-693.step x 2
2026-01-28-18-03-35-694.step x 4
2026-01-28-18-03-35-695.step x 4
2026-01-28-18-03-35-696.step x 8
2026-01-28-18-03-35-697.step x 32
2026-01-28-18-03-35-698.step x 8
2026-01-28-18-03-35-701.step x 2
2026-01-28-18-03-35-677.step x 2
2026-01-28-18-03-35-679.step x 2
2026-01-28-18-03-19-296.step x 2
2026-01-28-18-03-19-297.step x 2
2026-01-28-18-03-19-298.step x 2
2026-01-28-18-03-19-299.step x 2
2026-01-28-18-03-19-300.step x 2
2026-01-28-18-03-19-301.step x 2
2026-01-28-18-03-19-302.step x 2
2026-01-28-18-03-38-226.step x 2
2026-01-28-18-03-38-227.step x 2
2026-01-28-18-03-38-228.step x 2
2026-01-28-18-03-38-229.step x 2
2026-01-28-18-03-38-230.step x 2
2026-01-28-18-03-38-231.step x 2
2026-01-28-18-03-38-232.step x 2
2026-01-28-18-03-38-233.step x 2
2026-01-28-18-03-38-234.step x 2
2026-01-28-18-03-38-235.step x 2
2026-01-28-18-03-27-436.step x 2
2026-01-28-18-03-27-437.step x 2
2026-01-28-18-03-27-438.step x 2
2026-01-28-18-03-27-439.step x 2
2026-01-28-18-03-27-440.step x 2
2026-01-28-18-03-27-441.step x 2
2026-01-28-18-03-27-442.step x 2
2026-01-28-18-03-42-256.step x 4
2026-01-28-18-03-15-810.step x 4
2026-01-28-18-03-13-456.step x 2
2026-01-28-18-04-02-818.step x 2
Frame Slider x 2
Motor Housing x 2
Input shaft - p1.STEP x 2
Input shaft - p2.STEP x 2
Input shaft - p3.STEP x 2
Input shaft - p4.STEP x 2
Distance ring 1mm ID 15mm.STEP x 12
Ball Bearing-15x24x5mm_Ball Bearing 608 - 8x22x7mm.STEP x 8
Roller pins housing.STEP x 2
6mm shaft for roller pins.STEP x 32
Spacer 6mm ID.STEP x 32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
