jackalaka21/MnT_exoskeleton/(list of files, cad)

Other CAD files:
Hip Component/Assem1.SLDASM
Cycloidal_Gearbox/Input shaft sub-assembly v2.STEP.SLDASM
Cycloidal_Gearbox/EN ISO 4762 M4 x 40 - 20N_EN ISO 4762 M4 x 40 - 20N.STEP.SLDPRT
Cycloidal_Gearbox/Input shaft - p1.STEP.SLDPRT
Cycloidal_Gearbox/Input shaft - p2.STEP.SLDPRT
Hip Component/HC2.SLDPRT
Cycloidal_Gearbox/Distance ring 1mm ID 6mm.STEP.SLDPRT
Cycloidal_Gearbox/Roller pins housing lid.STEP.SLDPRT
Cut-Extrude9.SLDPRT
Cycloidal_Gearbox/EN ISO 4762 M3 x 8 - 8N_EN ISO 4762 M3 x 8 - 8N.STEP.SLDPRT
Cycloidal_Gearbox/Input shaft - p4.STEP.SLDPRT
E Box 1.SLDPRT
Cycloidal_Gearbox/Threaded insert M3 - L5mm.STEP.SLDPRT
Cycloidal_Gearbox/Ball Bearing-35x47x7mm_Ball Bearing 608 - 8x22x7mm.STEP.SLDPRT
Cycloidal_Gearbox/Ball Bearing-15x24x5mm_Ball Bearing 608 - 8x22x7mm.STEP.SLDPRT
Cycloidal_Gearbox/Nema 17 shaft coupler.STEP.SLDPRT
Cycloidal_Gearbox/NEMA 17 motor mount.STEP.SLDPRT
Cycloidal_Gearbox/Spacer 6mm ID v3.STEP.SLDPRT
Cycloidal_Gearbox/EN ISO 4762 M3 x 10 - 10N_EN ISO 4762 M3 x 10 - 10N.STEP.SLDPRT
Cycloidal_Gearbox/Distance ring 1mm ID 15mm.STEP.SLDPRT
Cycloidal_Gearbox/Threaded insert M4 - L5mm.STEP.SLDPRT
Cycloidal_Gearbox/Cycloidal disk.STEP.SLDPRT
Cycloidal_Gearbox/Ball Bearing- 6x13x5mm_Ball Bearing 608 - 8x22x7mm.STEP.SLDPRT
Cycloidal_Gearbox/Output disk flange p2.STEP.SLDPRT
Cycloidal_Gearbox/EN ISO 4762 M3 x 30 - 18N_EN ISO 4762 M3 x 30 - 18N.STEP.SLDPRT
Cycloidal_Gearbox/Cycloidal disk 2.STEP.SLDPRT
Cycloidal_Gearbox/Output disk flange p1.STEP.SLDPRT
Cycloidal_Gearbox/Roller pins housing.STEP.SLDPRT
Cycloidal_Gearbox/Input shaft - p3.STEP.SLDPRT
Cycloidal_Gearbox/Spacer 6mm ID.STEP.SLDPRT
BR1.STL
BR2.STL
Cycloidal_Gearbox/DIN 912 M3 x 20 --- 20N_DIN 912 M3 x 20 --- 20N.STEP.SLDPRT
Cycloidal_Gearbox/PM6025 - Cycloidal Adapter.STL
Cycloidal_Gearbox/Shaft for Motor-Gearbox Adapter.STL
Cycloidal_Gearbox/Spacer 6mm ID v2.STEP.SLDPRT
Handle.STL
